jiseo0ok/rasberry-ycbar/README.md

1) 안드로이드 어플리케이션 활용 주문
안드로이드 어플리케이션에 기본으로 등록되어 있는 칵테일 레시피를 사용하거나, 사용자별 맞춤 레시피를 등록할 수 있으며 등록되어 있는 특정 레시피를 선택할 시 해당 레시피를 ‘칵테일 제조 머신’으로 전달해준다.
2) 하드웨어로 자동 제조
안드로이드 어플리케이션에서 사용자가 선택한 레시피를 전달받고 해당 레시피에 따라서 칵테일을 완전 자동으로 제조한다.
3) AI 음성인식을 사용한 레시피와 노래 추천
AI 음성인식 기술을 통하여 도수에 따른 칵테일 레시피를 추천을 받을 수 있고 사용자가 원하는 분위기에 따른 노래 또한 추천을 받을 수 있다.
