jiseo0ok/rasberry-ycbar/아두이노/test/360servo_test/360servo_test.ino

#include <Servo.h>

Servo myservo;

void setup() {
  myservo.attach(8);
}

void loop() {
  myservo.write(180);
  delay(1000);
  myservo.write(90);
  delay(1000);
  myservo.write(0);
  delay(1000);
  myservo.write(90);
  delay(1000);

  myservo.write(135);
  delay(1000);
  myservo.write(90);
  delay(1000);
  myservo.write(45);
  delay(1000);
  myservo.write(90);
  delay(1000);
}
